Nathan-K-Public/cable-tester/v1.0-unstable/Schematic-v1.0.jpg

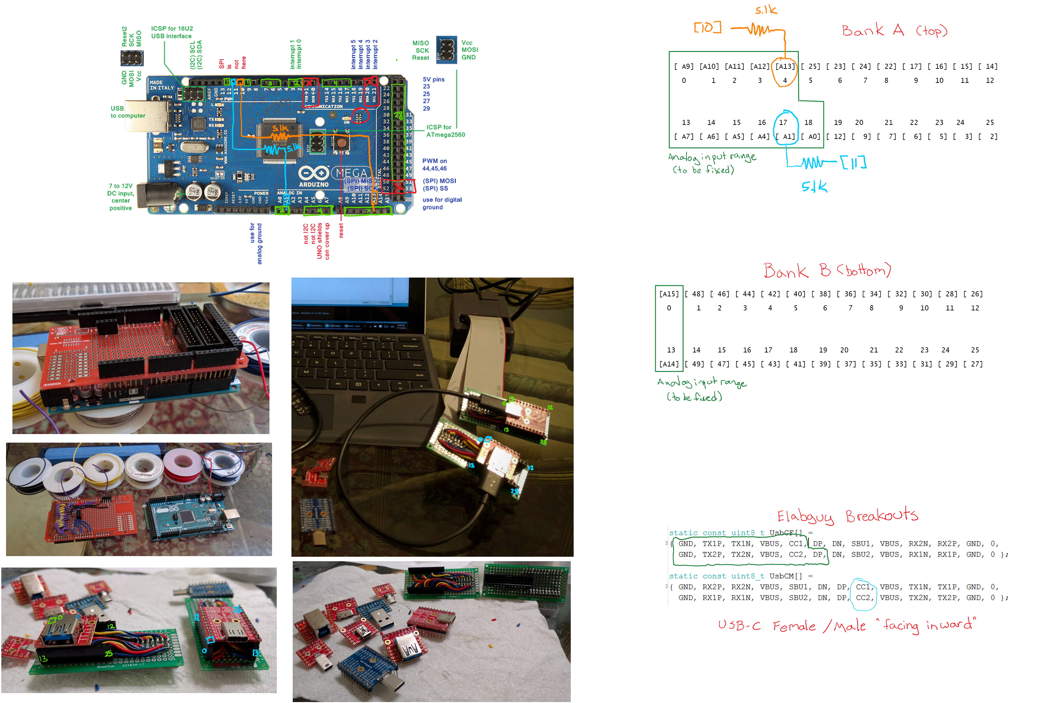
v1.0-unstable/Schematic-v1.0.jpg
