Nathan-K-Public/cable-tester/v1.0-unstable/README.md

# cable-tester-v1.0
Arduino Cable Tester based on Mega2560

Project development collection can be found here on Google Plus:
https://plus.google.com/collection/YVyBSB

Video of tester in action can be seen here:
https://plus.google.com/102612254593917101378/posts/ViVuKPyG9Dn

There are many things I would change/fix/optimize, but this works for now. I will revisit this in the near future to correct design oversights.

Please note this leaves pins necessary for Adafruit Joystick TFt use exposed. You may need to reroute the SPI pins and shift pins 13-9 by using pin extenders, but it is possible to retain SPI and I2C functionality.
