Nathan-K-Public/cable-tester/v2.0-stable/CableTesterv2_breakoutMap.png

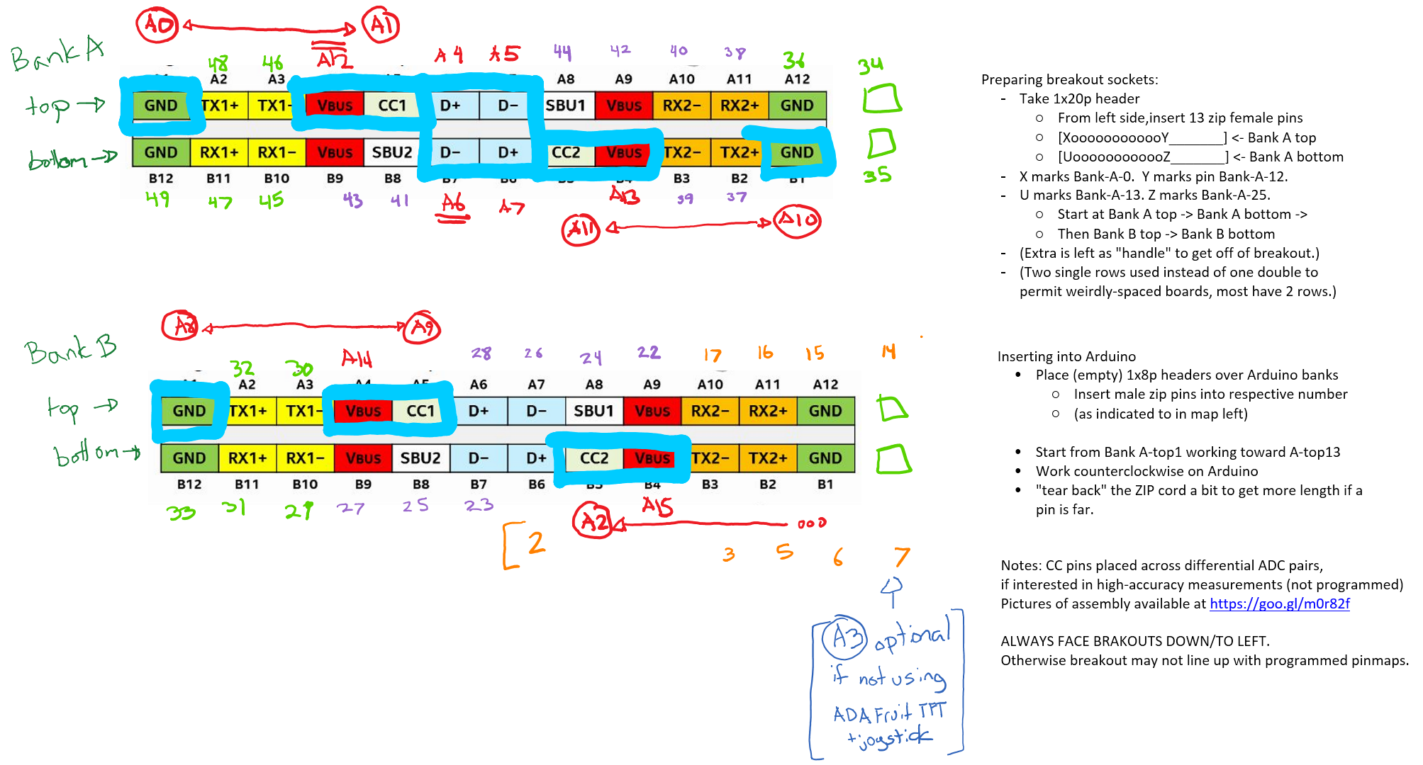
v2.0-stable/CableTesterv2_breakoutMap.png
