Nathan-K-Public/cable-tester/(commit log)

2016-07-16 Add rudementary schematic and sketch
    This diagram is my current setup. It is not optimized at all, but it works very well for what it needs to.
2016-07-29 Fixing directories try #2
    [Cable-tester-v1.0 (9_FINAL).ino]
2016-07-29 Add better Readme, JameCo shopping list
    [cart.csv]
2016-08-01 Remove three (!!!) in a row for clone Megas
    Clone Megas with a certain bootloader fail on upload with code with three (!!!) in a row. This is a patch.
    Proper fix is to update the bootloader on the Mega2560 clone with the official bootloader. Instructions below.
    "There are three possible reasons:
    (1) The code has three exclamation points in a row in the code, and when the serial chip sees that escape sequence on the bus (even in an upload) it triggers the bootloader to go nuts / reset. This is an issue with some clones.
    http://forum.arduino.cc/index.php?topic=83079.msg2668923#msg2668923
    (2) Other people say you just have to update your drivers with the ones contained in the Arduino d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
    [Is2_CableTester_2.0-003.ino]
2016-08-19 Fix pinDelay for line capacitance issues
    When using long ZipWires, capacitance of the wire itself can mess with "pin (t)est" mode. This shows up as BankA-1 GND and BankA-4 VBUS showing erratic false-positives.
    Add a small delay to allow ADC sampling capacitor to recharge.
    [Is2_CableTester_2.0-003.ino]
2016-11-05 Add v1.1 of eMarker decode
    Add active cable support and decoding
